prateekg986/sih_protowave/visuals/bottle-prototype-render-labelled-final.png

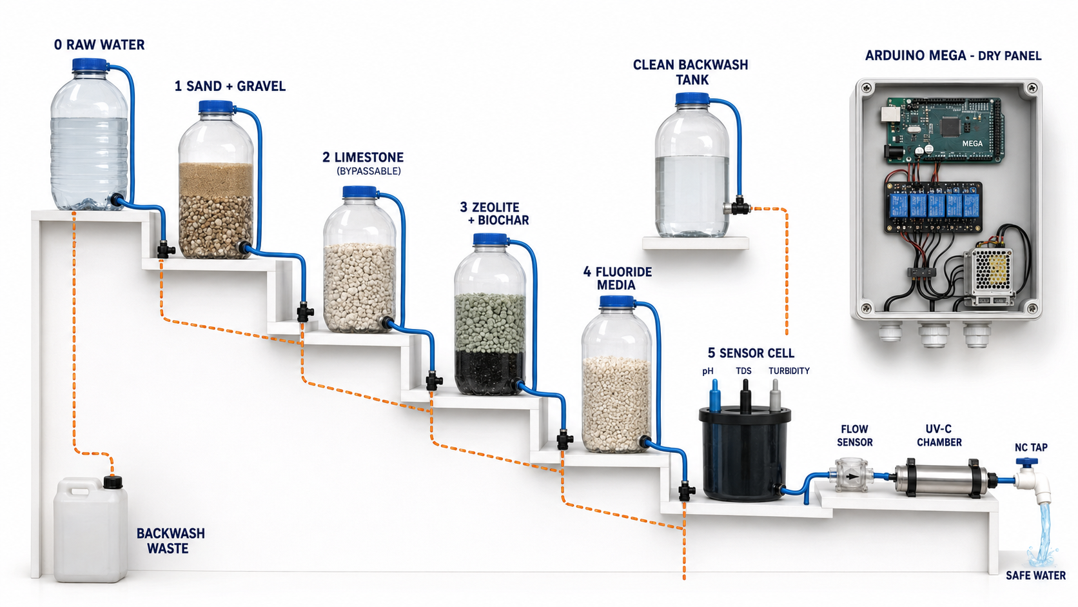
visuals/bottle-prototype-render-labelled-final.png
