prateekg986/sih_protowave/visuals/equipment-placement-schematic.png

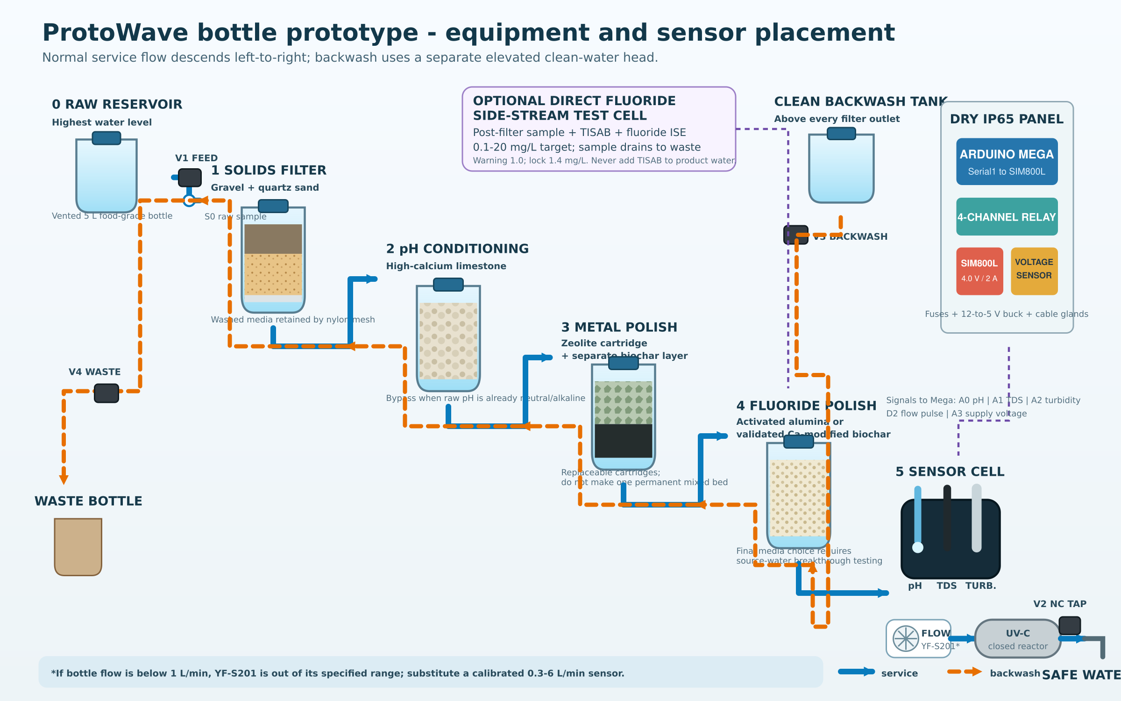
visuals/equipment-placement-schematic.png
